daPhoosa/Gaggia_Guru/PCB/Fab GaggiaGuru/GaggiaGuruBOM.csv

Reference | Qty | Value | Footprint | Datasheet | LCSC Part #
C1 | 1 | 100uF | Capacitor_THT:CP_Radial_D6.3mm_P2.50mm
C2,C4,C5,C6,C8,C9,C10,C11,C12 | 9 | 100nF | Capacitor_SMD:C_0805_2012Metric
C3,C7 | 2 | 10nF | Capacitor_SMD:C_0805_2012Metric
D1,D3,D4,D5,D6,D7,D8 | 7 | red | LED_SMD:LED_0805_2012Metric
D2 | 1 | SS14 | Diode_SMD:D_SMA
F1 | 1 | 1.1A (MF-MSMF110) | Fuse:Fuse_1812_4532Metric
J1 | 1 | 5V IN | Connector_JST:JST_XH_B2B-XH-A_1x02_P2.50mm_Vertical
J2 | 1 | SSR HEATER | Connector_JST:JST_XH_B2B-XH-A_1x02_P2.50mm_Vertical
J3 | 1 | SSR VALVE | Connector_JST:JST_XH_B2B-XH-A_1x02_P2.50mm_Vertical
J4 | 1 | RELAY COFFEE LAMP | Connector_JST:JST_XH_B2B-XH-A_1x02_P2.50mm_Vertical
J5 | 1 | RELAY STEAM LAMP | Connector_JST:JST_XH_B2B-XH-A_1x02_P2.50mm_Vertical
J6 | 1 | DIMMER | Connector_JST:JST_XH_B4B-XH-A_1x04_P2.50mm_Vertical
J7 | 1 | SWITCHES | Connector_JST:JST_XH_B4B-XH-A_1x04_P2.50mm_Vertical
J8 | 1 | THERMOCOUPLE | Connector_JST:JST_XH_B2B-XH-A_1x02_P2.50mm_Vertical
J9 | 1 | PRESSURE | Connector_JST:JST_XH_B3B-XH-A_1x03_P2.50mm_Vertical
J10 | 1 | HX711 | Connector_JST:JST_XH_B4B-XH-A_1x04_P2.50mm_Vertical
J11 | 1 | I2C | Connector_JST:JST_XH_B4B-XH-A_1x04_P2.50mm_Vertical
J12 | 1 | SPARE | Connector_JST:JST_XH_B6B-XH-A_1x06_P2.50mm_Vertical
J13 | 1 | SPI | Connector_JST:JST_XH_B7B-XH-A_1x07_P2.50mm_Vertical
J14 | 1 | ANALOG | Connector_JST:JST_XH_B5B-XH-A_1x05_P2.50mm_Vertical
Q1,Q2,Q3,Q4 | 4 | AO3400A | Package_TO_SOT_SMD:SOT-23 | http://www.aosmd.com/pdfs/datasheet/AO3400A.pdf
R1,R2,R4,R5,R7,R8,R10,R11,R13,R17,R20 | 11 | 1k | Resistor_SMD:R_0805_2012Metric
R3,R6,R9,R12,R14,R15,R18,R21,R22,R23,R26,R27,R30 | 13 | 10k 1% | Resistor_SMD:R_0805_2012Metric
R16,R19 | 2 | 330 | Resistor_SMD:R_0805_2012Metric
R24,R25 | 2 | 4.7k | Resistor_SMD:R_0805_2012Metric
R28,R29 | 2 | 33 | Resistor_SMD:R_0805_2012Metric
U1 | 1 | ESP32-WROOM-32U | GaggiaGuru:ESP32U-38_P25.4mm | https://docs.espressif.com/projects/esp-dev-kits/en/latest/esp32/esp32-devkitc/user_guide.html
U2 | 1 | MAX31855KASA+ | Package_SO:SOIC-8_3.9x4.9mm_P1.27mm | https://www.analog.com/media/en/technical-documentation/data-sheets/MAX31855.pdf
U3 | 1 | ADS1115IDGS | Package_SO:TSSOP-10_3x3mm_P0.5mm | https://www.ti.com/lit/ds/symlink/ads1115.pdf
