daPhoosa/Gaggia_Guru/PCB/production/bom.csv

Designator | Footprint | Quantity | Value | LCSC Part #
C1 | CP_Radial_D6.3mm_P2.50mm | 1 | 100uF
C10, C11, C12, C2, C4, C5, C6, C8, C9 | 0805 | 9 | 100nF
C3, C7 | 0805 | 2 | 10nF
D1, D3, D4, D5, D6, D7, D8 | 0805 | 7 | red
D2 | D_SMA | 1 | SS14
F1 | 1812 | 1 | 1.1A (MF-MSMF110)
J1 | JST_XH_B2B-XH-A_1x02_P2.50mm_Vertical | 1 | 5V IN
J10 | JST_XH_B4B-XH-A_1x04_P2.50mm_Vertical | 1 | HX711
J11 | JST_XH_B4B-XH-A_1x04_P2.50mm_Vertical | 1 | I2C
J12 | JST_XH_B6B-XH-A_1x06_P2.50mm_Vertical | 1 | SPARE
J13 | JST_XH_B7B-XH-A_1x07_P2.50mm_Vertical | 1 | SPI
J14 | JST_XH_B5B-XH-A_1x05_P2.50mm_Vertical | 1 | ANALOG
J2 | JST_XH_B2B-XH-A_1x02_P2.50mm_Vertical | 1 | SSR HEATER
J3 | JST_XH_B2B-XH-A_1x02_P2.50mm_Vertical | 1 | SSR VALVE
J4 | JST_XH_B2B-XH-A_1x02_P2.50mm_Vertical | 1 | RELAY COFFEE LAMP
J5 | JST_XH_B2B-XH-A_1x02_P2.50mm_Vertical | 1 | RELAY STEAM LAMP
J6 | JST_XH_B4B-XH-A_1x04_P2.50mm_Vertical | 1 | DIMMER
J7 | JST_XH_B4B-XH-A_1x04_P2.50mm_Vertical | 1 | SWITCHES
J8 | JST_XH_B2B-XH-A_1x02_P2.50mm_Vertical | 1 | THERMOCOUPLE
J9 | JST_XH_B3B-XH-A_1x03_P2.50mm_Vertical | 1 | PRESSURE
Q1, Q2, Q3, Q4 | SOT-23 | 4 | AO3400A
R1, R10, R11, R13, R17, R2, R20, R4, R5, R7, R8 | 0805 | 11 | 1k
R12, R14, R15, R18, R21, R22, R23, R26, R27, R3, R30, R6, R9 | 0805 | 13 | 10k 1%
R16, R19 | 0805 | 2 | 330
R24, R25 | 0805 | 2 | 4.7k
R28, R29 | 0805 | 2 | 33
U1 | ESP32U-38_P25.4mm | 1 | ESP32-WROOM-32U
U2 | SOIC-8_3.9x4.9mm_P1.27mm | 1 | MAX31855KASA+
U3 | TSSOP-10_3x3mm_P0.5mm | 1 | ADS1115IDGS
