daPhoosa/Gaggia_Guru/PCB/RelayBoard/RelayBoard.kicad_pcb

## KiCad design PCB/RelayBoard/RelayBoard.kicad_pcb (2026-11-10)

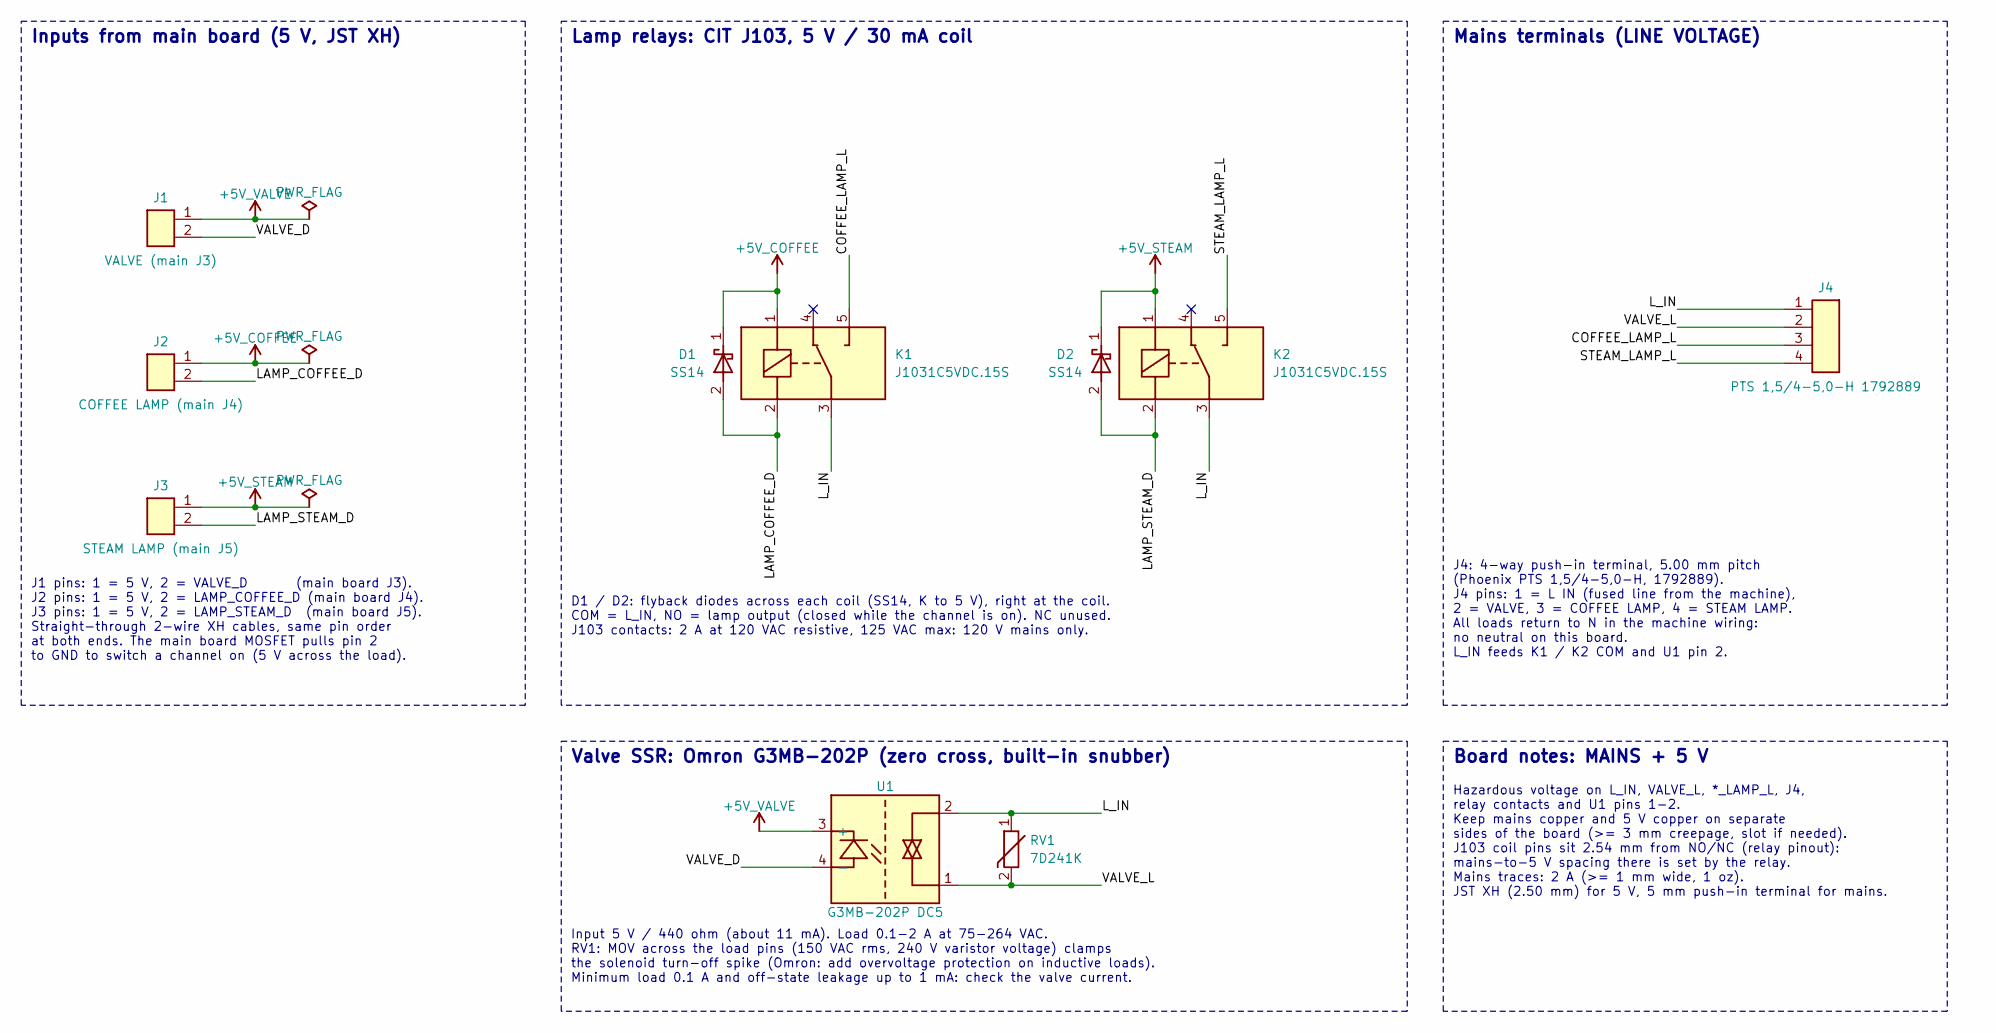
[picture p1: schematic RelayBoard.kicad_sch, Gaggia Guru - relay board]

Parts:
D1, D2: SS14; D_SMA
J1: VALVE (main J3); JST_XH_B2B-XH-A_1x02_P2.50mm_Vertical
J2: COFFEE LAMP (main J4); JST_XH_B2B-XH-A_1x02_P2.50mm_Vertical
J3: STEAM LAMP (main J5); JST_XH_B2B-XH-A_1x02_P2.50mm_Vertical
J4: PTS 1,5/4-5,0-H 1792889; TerminalBlock_Phoenix_MKDS-1,5-4_1x04_P5.00mm_Horizontal; MPN 1792889
K1, K2: J1031C5VDC.15S; Relay_SPDT_CIT_J103
RV1: 7D241K; RV_Disc_D7mm_W3.4mm_P5mm
U1: G3MB-202P DC5; SSR_Omron_G3MB-202P

Connections:
+5V_COFFEE: D1.1 (K), J2.1, K1.1
+5V_STEAM: D2.1 (K), J3.1, K2.1
+5V_VALVE: J1.1, U1.3 (+)
/COFFEE_LAMP_L: J4.3, K1.5 (NO)
/LAMP_COFFEE_D: D1.2 (A), J2.2, K1.2
/LAMP_STEAM_D: D2.2 (A), J3.2, K2.2
/L_IN: J4.1, K1.3 (COM), K2.3 (COM), RV1.1, U1.2
/STEAM_LAMP_L: J4.4, K2.5 (NO)
/VALVE_D: J1.2, U1.4 (-)
/VALVE_L: J4.2, RV1.2, U1.1

Notes on the sheet:
Mains terminals (LINE VOLTAGE)
Board notes: MAINS + 5 V
J4: 4-way push-in terminal, 5.00 mm pitch (Phoenix PTS 1,5/4-5,0-H, 1792889). J4 pins: 1 = L IN (fused line from the machine), 2 = VALVE, 3 = COFFEE LAMP, 4 = STEAM LAMP. All loads return to N in the machine wiring: no neutral on this board. L_IN feeds K1 / K2 COM and U1 pin 2.
D1 / D2: flyback diodes across each coil (SS14, K to 5 V), right at the coil. COM = L_IN, NO = lamp output (closed while the channel is on). NC unused. J103 contacts: 2 A at 120 VAC resistive, 125 VAC max: 120 V mains only.
Valve SSR: Omron G3MB-202P (zero cross, built-in snubber)
Lamp relays: CIT J103, 5 V / 30 mA coil
Hazardous voltage on L_IN, VALVE_L, *_LAMP_L, J4, relay contacts and U1 pins 1-2. Keep mains copper and 5 V copper on separate sides of the board (>= 3 mm creepage, slot if needed). J103 coil pins sit 2.54 mm from NO/NC (relay pinout): mains-to-5 V spacing there is set by the relay. Mains traces: 2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
Inputs from main board (5 V, JST XH)
J1 pins: 1 = 5 V, 2 = VALVE_D (main board J3). J2 pins: 1 = 5 V, 2 = LAMP_COFFEE_D (main board J4). J3 pins: 1 = 5 V, 2 = LAMP_STEAM_D (main board J5). Straight-through 2-wire XH cables, same pin order at both ends. The main board MOSFET pulls pin 2 to GND to switch a channel on (5 V across the loa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
Input 5 V / 440 ohm (about 11 mA). Load 0.1-2 A at 75-264 VAC. RV1: MOV across the load pins (150 VAC rms, 240 V varistor voltage) clamps the solenoid turn-off spike (Omron: add overvoltage protection on inductive loads). Minimum load 0.1 A and off-state leakage up to 1 mA: check the valve current.

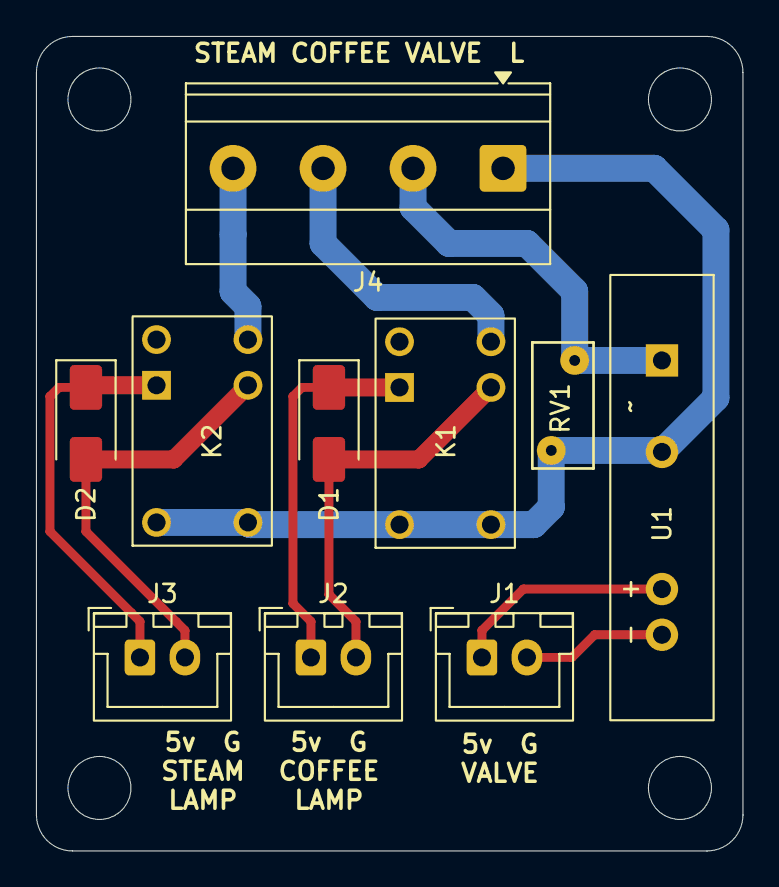
[picture p2: board RelayBoard.kicad_pcb from above]

Board: 2 copper layers, 39.2 x 45.2 mm, 10 parts (0 on the bottom side), 10 nets.
