daPhoosa/Gaggia_Guru/PCB/GaggiaGuru.kicad_pcb

## KiCad design PCB/GaggiaGuru.kicad_pcb (2026-11-09)

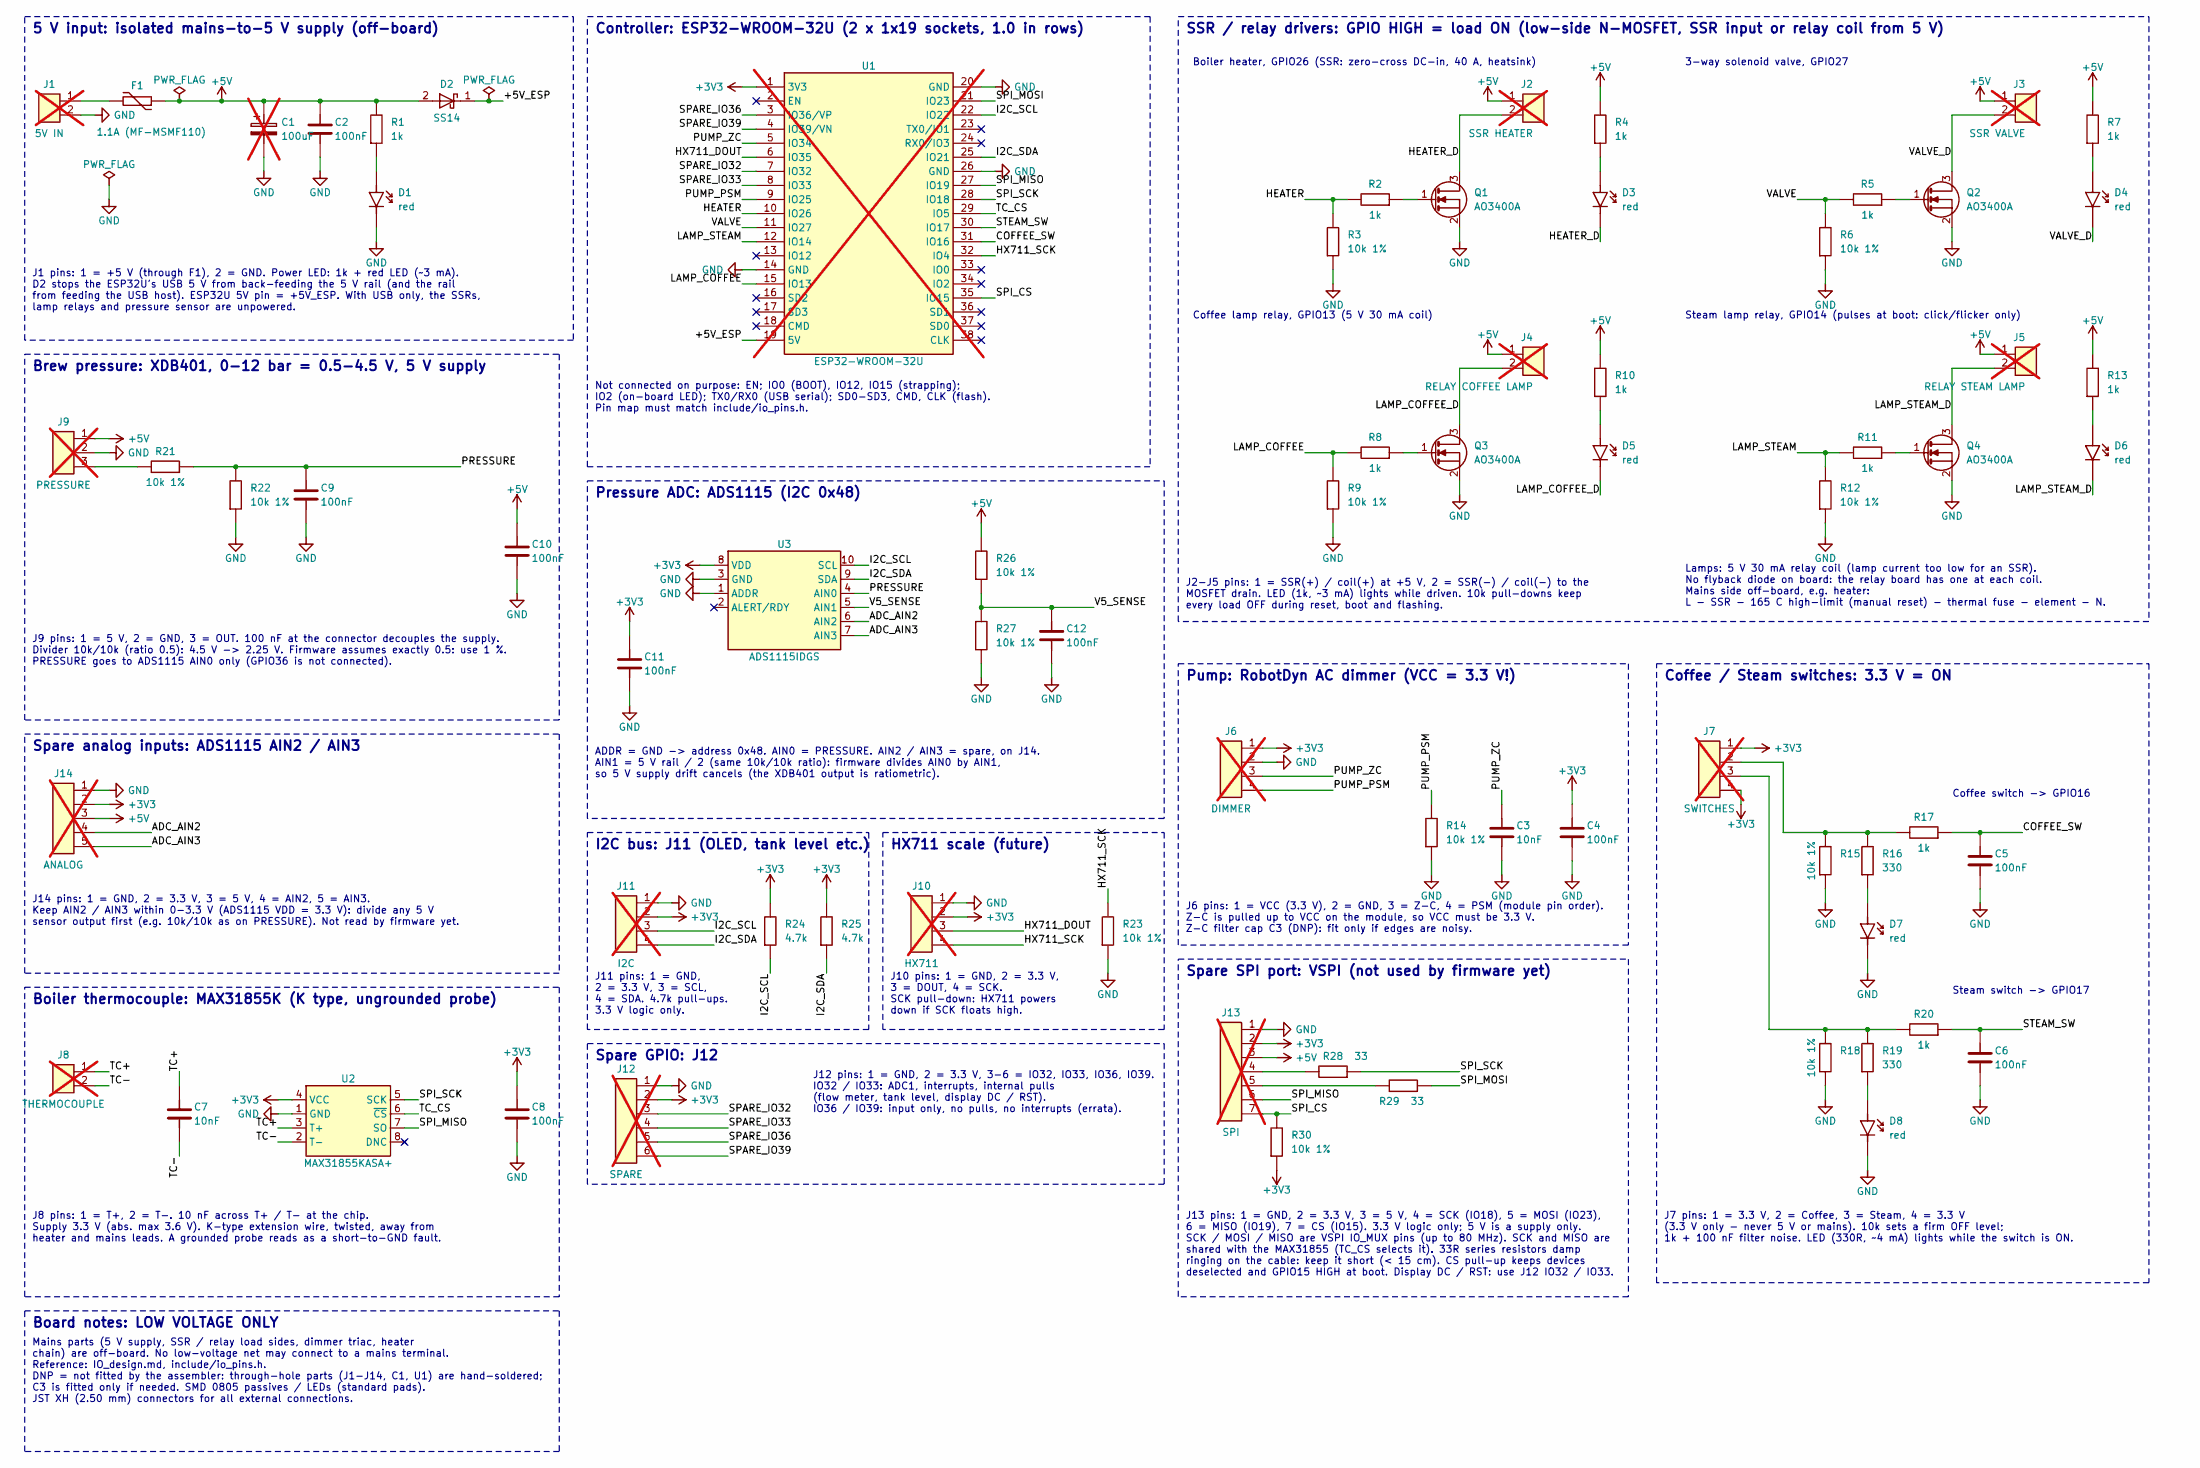
[picture p3: schematic GaggiaGuru.kicad_sch, Gaggia Guru - ESP32 controller]

Parts:
C1: 100uF; CP_Radial_D6.3mm_P2.50mm; Rating 10 V min, low ESR, radial THT; not fitted
C2, C4, C5, C6, C8, C9, C10, C11, C12: 100nF; C_0805_2012Metric
C3, C7: 10nF; C_0805_2012Metric
D1, D3, D4, D5, D6, D7, D8: red; LED_0805_2012Metric
D2: SS14; D_SMA
F1: 1.1A (MF-MSMF110); Fuse_1812_4532Metric
J1: 5V IN; JST_XH_B2B-XH-A_1x02_P2.50mm_Vertical; not fitted
J2: SSR HEATER; JST_XH_B2B-XH-A_1x02_P2.50mm_Vertical; not fitted
J3: SSR VALVE; JST_XH_B2B-XH-A_1x02_P2.50mm_Vertical; not fitted
J4: RELAY COFFEE LAMP; JST_XH_B2B-XH-A_1x02_P2.50mm_Vertical; not fitted
J5: RELAY STEAM LAMP; JST_XH_B2B-XH-A_1x02_P2.50mm_Vertical; not fitted
J6: DIMMER; JST_XH_B4B-XH-A_1x04_P2.50mm_Vertical; not fitted
J7: SWITCHES; JST_XH_B4B-XH-A_1x04_P2.50mm_Vertical; not fitted
J8: THERMOCOUPLE; JST_XH_B2B-XH-A_1x02_P2.50mm_Vertical; not fitted
J9: PRESSURE; JST_XH_B3B-XH-A_1x03_P2.50mm_Vertical; not fitted
J10: HX711; JST_XH_B4B-XH-A_1x04_P2.50mm_Vertical; not fitted
J11: I2C; JST_XH_B4B-XH-A_1x04_P2.50mm_Vertical; not fitted
J12: SPARE; JST_XH_B6B-XH-A_1x06_P2.50mm_Vertical; not fitted
J13: SPI; JST_XH_B7B-XH-A_1x07_P2.50mm_Vertical; not fitted
J14: ANALOG; JST_XH_B5B-XH-A_1x05_P2.50mm_Vertical; not fitted
Q1, Q2, Q3, Q4: AO3400A; SOT-23
R1, R2, R4, R5, R7, R8, R10, R11, R13, R17, R20: 1k; R_0805_2012Metric
R3, R6, R9, R12, R14, R15, R18, R21, R22, R23, R26, R27, R30: 10k 1%; R_0805_2012Metric
R16, R19: 330; R_0805_2012Metric
R24, R25: 4.7k; R_0805_2012Metric
R28, R29: 33; R_0805_2012Metric
U1: ESP32-WROOM-32U; ESP32U-38_P25.4mm; not fitted
U2: MAX31855KASA+; SOIC-8_3.9x4.9mm_P1.27mm
U3: ADS1115IDGS; TSSOP-10_3x3mm_P0.5mm

Connections:
+3V3: C4.1, C8.1, C11.1, J6.1, J7.1, J7.4, J10.2, J11.2, J12.2, J13.2, J14.2, R24.1, R25.1, R30.2, U1.1 (3V3), U2.4 (VCC), U3.8 (VDD)
+5V: C1.1, C2.1, C10.1, D2.2 (A), F1.2, J2.1, J3.1, J4.1, J5.1, J9.1, J13.3, J14.3, R1.1, R4.1, R7.1, R10.1, R13.1, R26.1
/+5V_ESP: D2.1 (K), U1.19 (5V)
/ADC_AIN2: J14.4, U3.6 (AIN2)
/ADC_AIN3: J14.5, U3.7 (AIN3)
/COFFEE_SW: C5.1, R17.2, U1.31 (IO16)
/HEATER: R2.1, R3.1, U1.10 (IO26)
/HEATER_D: D3.1 (K), J2.2, Q1.3 (D)
/HX711_DOUT: J10.3, U1.6 (IO35)
/HX711_SCK: J10.4, R23.1, U1.32 (IO4)
/I2C_SCL: J11.3, R24.2, U1.22 (IO22), U3.10 (SCL)
/I2C_SDA: J11.4, R25.2, U1.25 (IO21), U3.9 (SDA)
/LAMP_COFFEE: R8.1, R9.1, U1.15 (IO13)
/LAMP_COFFEE_D: D5.1 (K), J4.2, Q3.3 (D)
/LAMP_STEAM: R11.1, R12.1, U1.12 (IO14)
/LAMP_STEAM_D: D6.1 (K), J5.2, Q4.3 (D)
/PRESSURE: C9.1, R21.2, R22.1, U3.4 (AIN0)
/PUMP_PSM: J6.4, R14.1, U1.9 (IO25)
/PUMP_ZC: C3.1, J6.3, U1.5 (IO34)
/SPARE_IO32: J12.3, U1.7 (IO32)
/SPARE_IO33: J12.4, U1.8 (IO33)
/SPARE_IO36: J12.5, U1.3 (IO36/VP)
/SPARE_IO39: J12.6, U1.4 (IO39/VN)
/SPI_CS: J13.7, R30.1, U1.35 (IO15)
/SPI_MISO: J13.6, U1.27 (IO19), U2.7 (SO)
/SPI_MOSI: R29.2, U1.21 (IO23)
/SPI_SCK: R28.2, U1.28 (IO18), U2.5 (SCK)
/STEAM_SW: C6.1, R20.2, U1.30 (IO17)
/TC+: C7.1, J8.1, U2.3 (T+)
/TC-: C7.2, J8.2, U2.2 (T-)
/TC_CS: U1.29 (IO5), U2.6 (~CS)
/V5_SENSE: C12.1, R26.2, R27.1, U3.5 (AIN1)
/VALVE: R5.1, R6.1, U1.11 (IO27)
/VALVE_D: D4.1 (K), J3.2, Q2.3 (D)
GND: C1.2, C2.2, C3.2, C4.2, C5.2, C6.2, C8.2, C9.2, C10.2, C11.2, C12.2, D1.1 (K), D7.1 (K), D8.1 (K), J1.2, J6.2, J9.2, J10.1, J11.1, J12.1, J13.1, J14.1, Q1.2 (S), Q2.2 (S), Q3.2 (S), Q4.2 (S), R3.2, R6.2, R9.2, R12.2, R14.2, R15.2, R18.2, R22.2, R23.2, R27.2, U1.14 (GND), U1.20 (GND), U1.26 (GND), U2.1 (GND), U3.1 (ADDR), U3.3 (GND)
unnamed: D1.2 (A), R1.2
unnamed: D3.2 (A), R4.2
unnamed: D4.2 (A), R7.2
unnamed: D5.2 (A), R10.2
unnamed: D6.2 (A), R13.2
unnamed: D7.2 (A), R16.2
unnamed: D8.2 (A), R19.2
unnamed: F1.1, J1.1
unnamed: J7.2, R15.1, R16.1, R17.1
unnamed: J7.3, R18.1, R19.1, R20.1
unnamed: J9.3, R21.1
unnamed: J13.4, R28.1
unnamed: J13.5, R29.1
unnamed: Q1.1 (G), R2.2
unnamed: Q2.1 (G), R5.2
unnamed: Q3.1 (G), R8.2
unnamed: Q4.1 (G), R11.2

Notes on the sheet:
Coffee / Steam switches: 3.3 V = ON
Lamps: 5 V 30 mA relay coil (lamp current too low for an SSR). No flyback diode on board: the relay board has one at each coil. Mains side off-board, e.g. heater: L - SSR - 165 C high-limit (manual reset) - thermal fuse - element - N.
Boiler thermocouple: MAX31855K (K type, ungrounded probe)
I2C bus: J11 (OLED, tank level etc.)
J12 pins: 1 = GND, 2 = 3.3 V, 3-6 = IO32, IO33, IO36, IO39. IO32 / IO33: ADC1, interrupts, internal pulls (flow meter, tank level, display DC / RST). IO36 / IO39: input only, no pulls, no interrupts (errata).
ADDR = GND -> address 0x48. AIN0 = PRESSURE. AIN2 / AIN3 = spare, on J14. AIN1 = 5 V rail / 2 (same 10k/10k ratio): firmware divides AIN0 by AIN1, so 5 V supply drift cancels (the XDB401 output is ratiometric).
Mains parts (5 V supply, SSR / relay load sides, dimmer triac, heater chain) are off-board. No low-voltage net may connect to a mains terminal. Reference: IO_design.md, include/io_pins.h. DNP = not fitted by the assembler: through-hole parts (J1-J14, C1, U1) are hand-soldered; C3 is fitted only if 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
Spare GPIO: J12
HX711 scale (future)
Pressure ADC: ADS1115 (I2C 0x48)
Steam switch -> GPIO17
Boiler heater, GPIO26 (SSR: zero-cross DC-in, 40 A, heatsink)
Steam lamp relay, GPIO14 (pulses at boot: click/flicker only)
Spare analog inputs: ADS1115 AIN2 / AIN3
3-way solenoid valve, GPIO27
Controller: ESP32-WROOM-32U (2 x 1x19 sockets, 1.0 in rows)
J14 pins: 1 = GND, 2 = 3.3 V, 3 = 5 V, 4 = AIN2, 5 = AIN3. Keep AIN2 / AIN3 within 0-3.3 V (ADS1115 VDD = 3.3 V): divide any 5 V sensor output first (e.g. 10k/10k as on PRESSURE). Not read by firmware yet.
J7 pins: 1 = 3.3 V, 2 = Coffee, 3 = Steam, 4 = 3.3 V (3.3 V only - never 5 V or mains). 10k sets a firm OFF level; 1k + 100 nF filter noise. LED (330R, ~4 mA) lights while the switch is ON.
Board notes: LOW VOLTAGE ONLY
J10 pins: 1 = GND, 2 = 3.3 V, 3 = DOUT, 4 = SCK. SCK pull-down: HX711 powers down if SCK floats high.
Coffee lamp relay, GPIO13 (5 V 30 mA coil)
J9 pins: 1 = 5 V, 2 = GND, 3 = OUT. 100 nF at the connector decouples the supply. Divider 10k/10k (ratio 0.5): 4.5 V -> 2.25 V. Firmware assumes exactly 0.5: use 1 %. PRESSURE goes to ADS1115 AIN0 only (GPIO36 is not connected).
Coffee switch -> GPIO16
J8 pins: 1 = T+, 2 = T-. 10 nF across T+ / T- at the chip. Supply 3.3 V (abs. max 3.6 V). K-type extension wire, twisted, away from heater and mains leads. A grounded probe reads as a short-to-GND fault.
J11 pins: 1 = GND, 2 = 3.3 V, 3 = SCL, 4 = SDA. 4.7k pull-ups. 3.3 V logic only.
J2-J5 pins: 1 = SSR(+) / coil(+) at +5 V, 2 = SSR(-) / coil(-) to the MOSFET drain. LED (1k, ~3 mA) lights while driven. 10k pull-downs keep every load OFF during reset, boot and flashing.
J6 pins: 1 = VCC (3.3 V), 2 = GND, 3 = Z-C, 4 = PSM (module pin order). Z-C is pulled up to VCC on the module, so VCC must be 3.3 V. Z-C filter cap C3 (DNP): fit only if edges are noisy.
Not connected on purpose: EN; IO0 (BOOT), IO12, IO15 (strapping); IO2 (on-board LED); TX0/RX0 (USB serial); SD0-SD3, CMD, CLK (flash). Pin map must match include/io_pins.h.
Spare SPI port: VSPI (not used by firmware yet)
Brew pressure: XDB401, 0-12 bar = 0.5-4.5 V, 5 V supply
J1 pins: 1 = +5 V (through F1), 2 = GND. Power LED: 1k + red LED (~3 mA). D2 stops the ESP32U's USB 5 V from back-feeding the 5 V rail (and the rail from feeding the USB host). ESP32U 5V pin = +5V_ESP. With USB only, the SSRs, lamp relays and pressure sensor are unpowered.
J13 pins: 1 = GND, 2 = 3.3 V, 3 = 5 V, 4 = SCK (IO18), 5 = MOSI (IO23), 6 = MISO (IO19), 7 = CS (IO15). 3.3 V logic only; 5 V is a supply only. SCK / MOSI / MISO are VSPI IO_MUX pins (up to 80 MHz). SCK and MISO are shared with the MAX31855 (TC_CS selects it). 33R series resistors damp ringing on t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
SSR / relay drivers: GPIO HIGH = load ON (low-side N-MOSFET, SSR input or relay coil from 5 V)
Pump: RobotDyn AC dimmer (VCC = 3.3 V!)
5 V input: isolated mains-to-5 V supply (off-board)

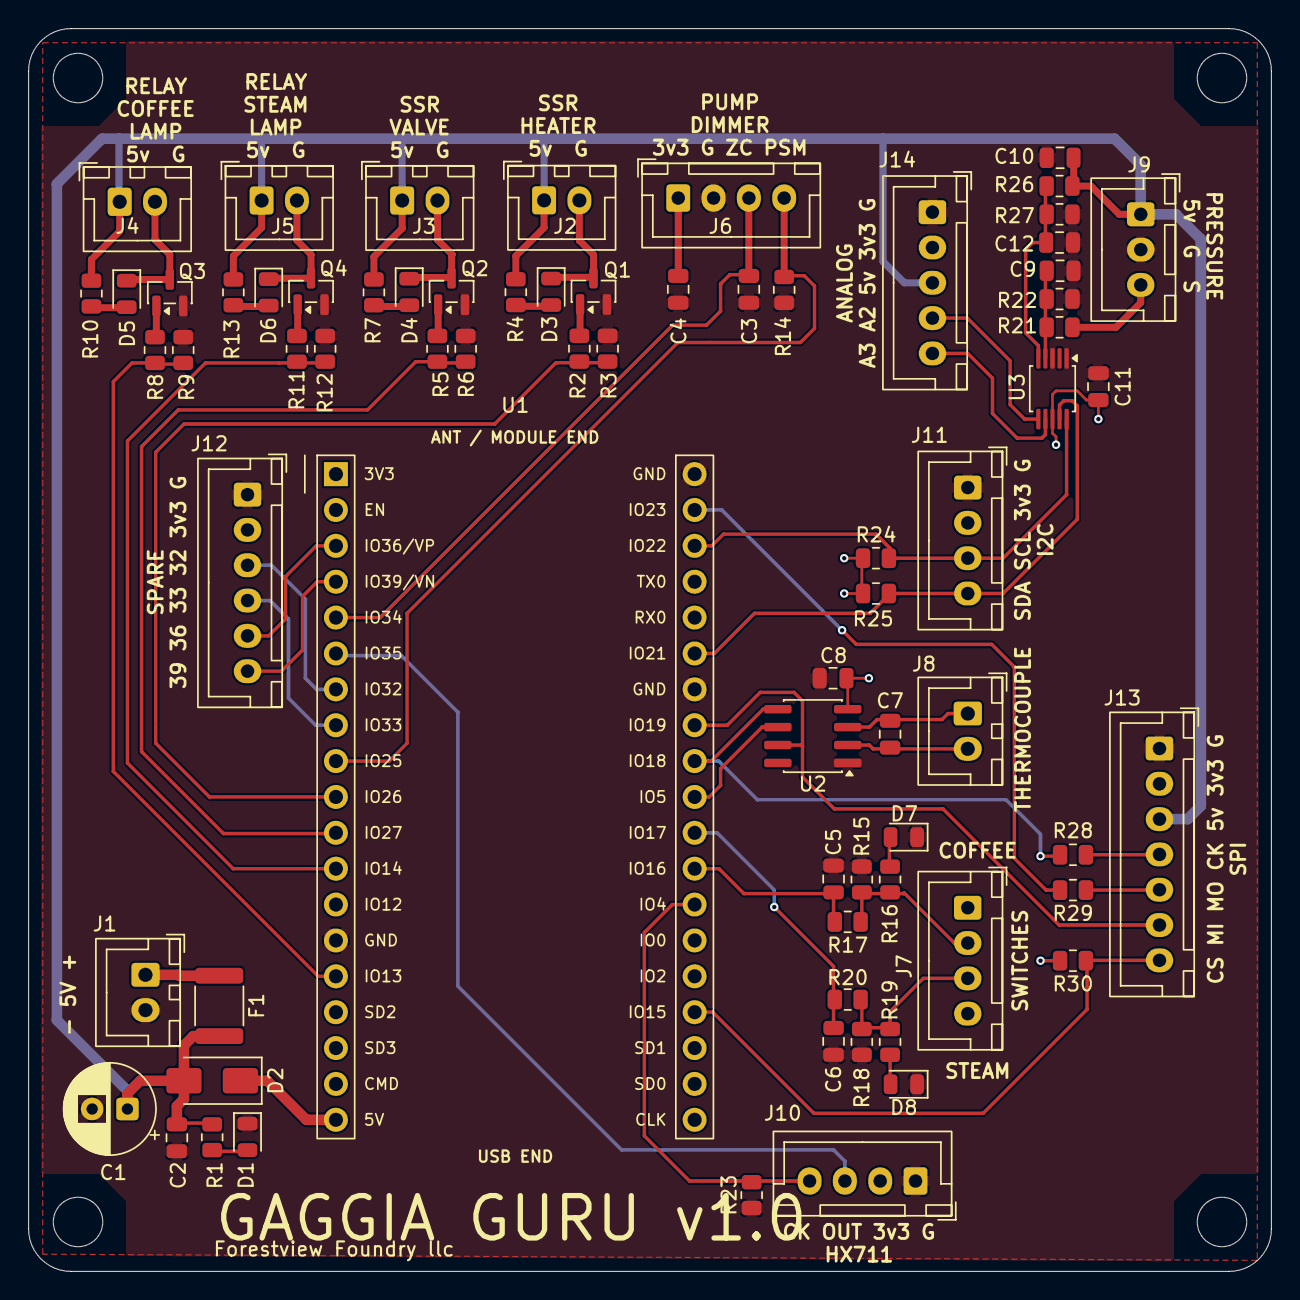
[picture p4: board GaggiaGuru.kicad_pcb from above]

Board: 2 copper layers, 88.0 x 88.0 mm, 72 parts (0 on the bottom side), 52 nets.
