daPhoosa/Gaggia_Guru/src/io_status.h

#pragma once
#include <Arduino.h>

// Read-only status of the pins listed in include/io_pins.h.
// Pins are sampled from the main loop by reading registers only (no writes,
// no pinMode). A pin whose input buffer is off shows no level. The ADC is
// never touched here. (Brew pressure is read by the ADS1115 over I2C, not an
// ESP32 pin.)
namespace IoStatus {

void begin();
void loop();         // samples pin states periodically
String json();       // {"pins":[...]} for /api/io

}  // namespace IoStatus
