daPhoosa/Gaggia_Guru/(commit log)

2026-11-02 Initial commit: Gaggia Savant base firmware
    [partitions.csv]
2026-11-03 Dashboard files remounted after a failed upload. Passwords moved out of git.
    [config.h, ota.cpp, ota_auth.py, secrets.example.h, web_server.cpp, wifi_manager.cpp]
2026-11-03 Upload error state shared
    [ota.cpp, web_server.cpp]
2026-11-03 IO Status page no longer changes any pin
    [io_status.cpp, io_status.h]
2026-11-03 Initial PCB Schematic
    [GaggiaSavant.kicad_sch]
2026-11-03 PCB Update
    [GaggiaSavant.kicad_pcb, GaggiaSavant.kicad_sch]
2026-11-03 Change project Name
    [GaggiaGuru.kicad_pcb, GaggiaGuru.kicad_sch]
2026-11-03 reliminate kicad backup files from repo
    [GaggiaGuru.kicad_pcb, GaggiaGuru.kicad_sch]
2026-11-03 Pressure sensor only connects to the ADS1115
    [GaggiaGuru.kicad_pcb, GaggiaGuru.kicad_sch]
2026-11-03 Add extra SPI port
    [GaggiaGuru.kicad_pcb, GaggiaGuru.kicad_sch]
2026-11-04 Change lamp drivers to support relays.
    [GaggiaGuru.kicad_pcb, GaggiaGuru.kicad_sch]
2026-11-05 PCB fix header pin order and remove unused footprints
    [GaggiaGuru.kicad_pcb, GaggiaGuru.kicad_sch]
2026-11-07 Initial PCB component grouping
    [GaggiaGuru.kicad_pcb, GaggiaGuru.kicad_sch]
2026-11-09 PCB routed
    [GaggiaGuru.kicad_pcb, GaggiaGuru.kicad_sch]
2026-11-09 PCB FAB file and Relay Board
    [GaggiaGuru-B_Cu.gbr, GaggiaGuru-B_Mask.gbr, GaggiaGuru-B_Paste.gbr, GaggiaGuru-B_Silkscreen.gbr, GaggiaGuru-Edge_Cuts.gbr, GaggiaGuru-F_Cu.gbr, GaggiaGuru-F_Mask.gbr, GaggiaGuru-F_Paste.gbr]
2026-11-09 Add relay board
    [RelayBoard.kicad_pcb, RelayBoard.kicad_sch, bom.csv, designators.csv, positions.csv]
2026-11-10 Finalized relay board
    [RelayBoard.kicad_pcb, RelayBoard.kicad_sch, positions.csv]
